SteveLRojas/1602_display_usb_controller/README.md

# 1602_display_usb_controller
Small controller board for 1602, 2004 and similar displays. It is intended to be controlled by a python script.
