SteveLRojas/1602_display_usb_controller/HW/V1.0/3D_View.png

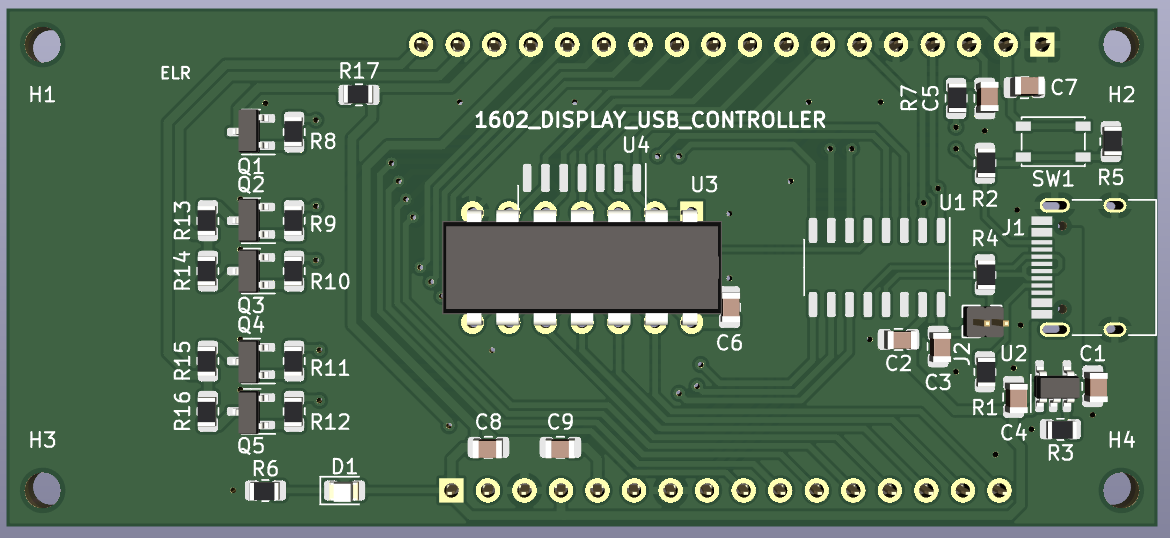
HW/V1.0/3D_View.png
