SteveLRojas/1602_display_usb_controller/HW/V1.0/BOM.ods

Part | #Needed | #Owned | Satisfied? | Location
CH552G | 1 | 10 | TRUE | Project Box
74164 | 1 | 5 | TRUE | TTL IC Box
MT9700 | 1 | 30 | TRUE | Project Box
PMBT3904 | 3 | 100 | TRUE | Project Box
LED Orange 0805 | 1 | 500 | TRUE | Project Box
USB-C Receptacle | 1 | 8 | TRUE | Connector Box
Resistor 0 ohm 0805 | 3 | 30 | TRUE | Box 8
Resistor 1k 0805 | 2 | 500 | TRUE | Box 8
Resistor 10k 0805 | 2 | 500 | TRUE | Box 8
Resistor 5.1k 0805 | 2 | 1000 | TRUE | Box 10
Resistor 4.7k 0805 | 4 | 50 | TRUE | Box 8
Capacitor 0.1u 0805 | 6 | 200 | TRUE | Project Box
Capacitor 1u 0805 | 3 | 300 | TRUE | Box 7
pin socket 1x16 2.54 | 1 | 50 | TRUE | Connector Box
pin socket 1x18 2.54 | 1 | 0 | FALSE | Connector Box
pin header 1x2 1.27 | 1 | 100 | TRUE | Connector Box
Push Button PTS810 | 1 | 10 | TRUE | Switch Box
