SteveLRojas/1602_display_usb_controller/3d_models/2004A_display_case_back.stl

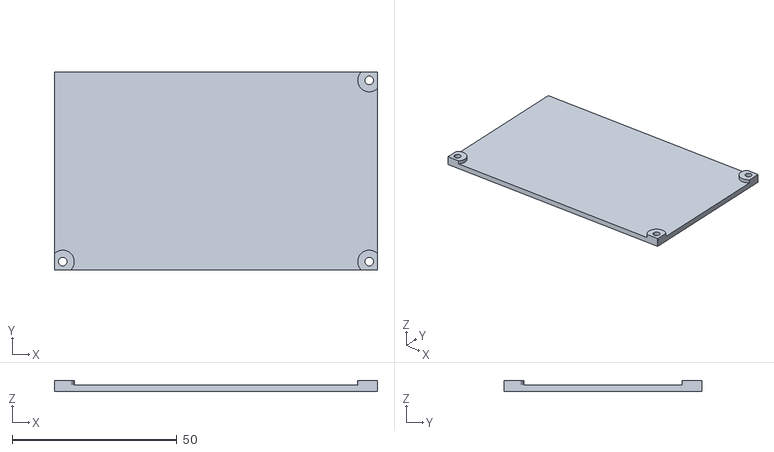
[picture p2: CAD file, 2026-07-25]
3d_models/2004A_display_case_back.stl
98.0 x 60.0 x 3.30
