SteveLRojas/1602_display_usb_controller/3d_models/2004A_display_case_front.stl

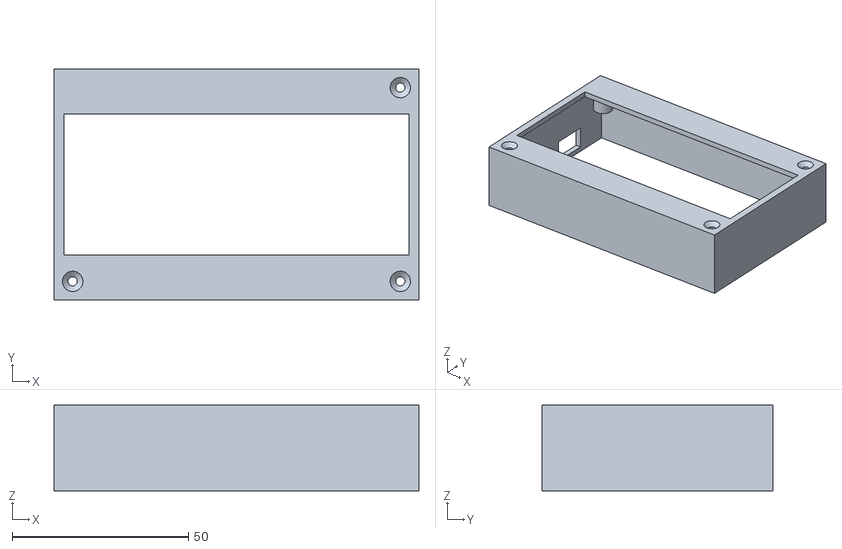
[picture p3: CAD file, 2026-07-25]
3d_models/2004A_display_case_front.stl
103.6 x 65.6 x 24.4
