SteveLRojas/1602_display_usb_controller/3d_models/RC2004C_display_case_front.stl

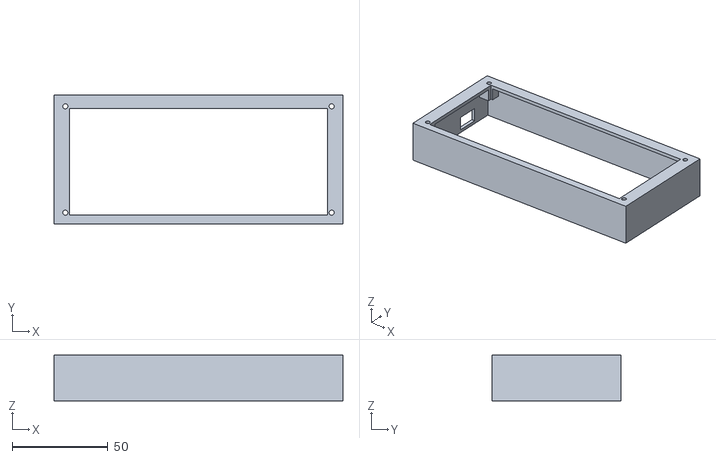
[picture p4: CAD file, 2026-07-25]
3d_models/RC2004C_display_case_front.stl
150.8 x 67.3 x 23.8
