SteveLRojas/1602_display_usb_controller/3d_models/RC2004C_display_case_back.stl

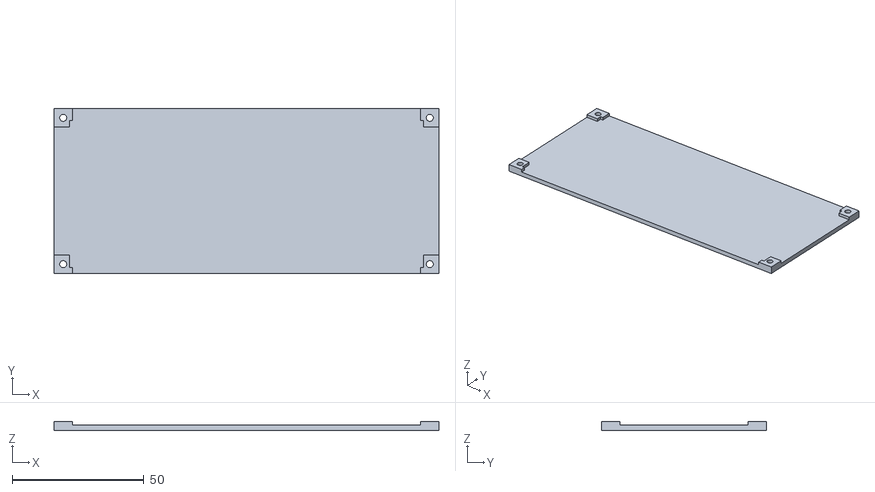
[picture p5: CAD file, 2026-07-25]
3d_models/RC2004C_display_case_back.stl
146.0 x 62.5 x 3.30
