SteveLRojas/1602_display_usb_controller/3d_models/1601_display_case_front_v8.stl

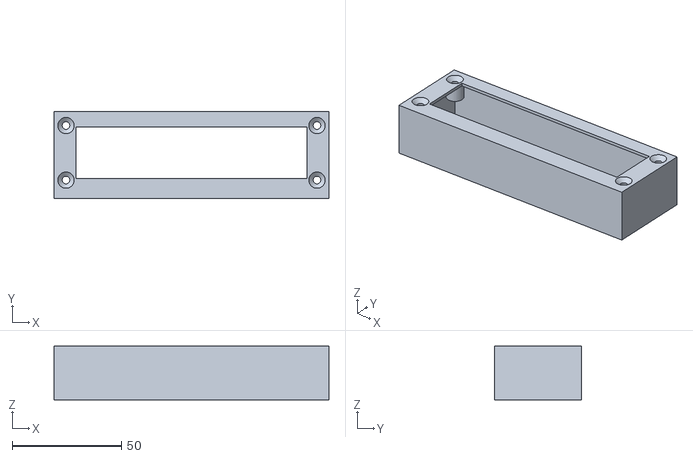
[picture p6: CAD file, 2026-07-19]
3d_models/1601_display_case_front_v8.stl
126.0 x 40.0 x 24.6
