SteveLRojas/1602_display_usb_controller/3d_models/RC1602E_display_case_front.stl

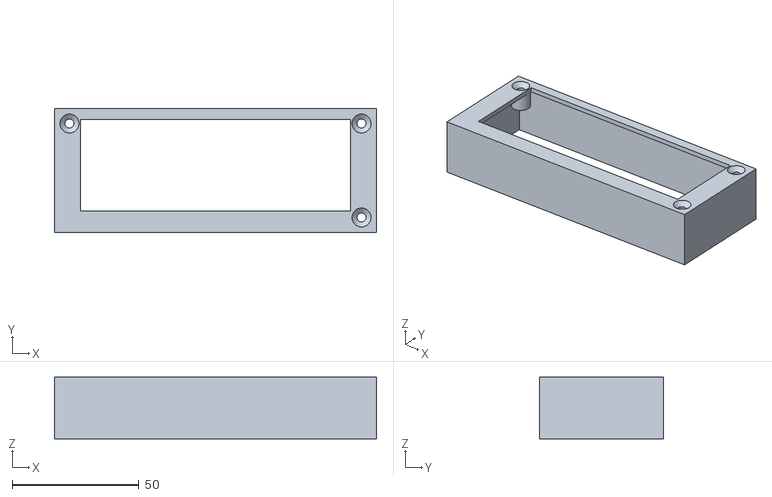
[picture p7: CAD file, 2026-07-19]
3d_models/RC1602E_display_case_front.stl
126.8 x 48.8 x 24.4
