SteveLRojas/1602_display_usb_controller/3d_models/RC1602_display_case_back.stl

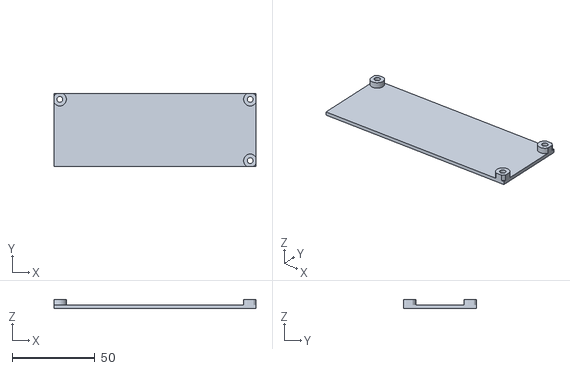
[picture p8: CAD file, 2026-07-19]
3d_models/RC1602_display_case_back.stl
122.0 x 44.0 x 5.30
