SteveLRojas/1602_display_usb_controller/3d_models/1602_display_case_back_v4.stl

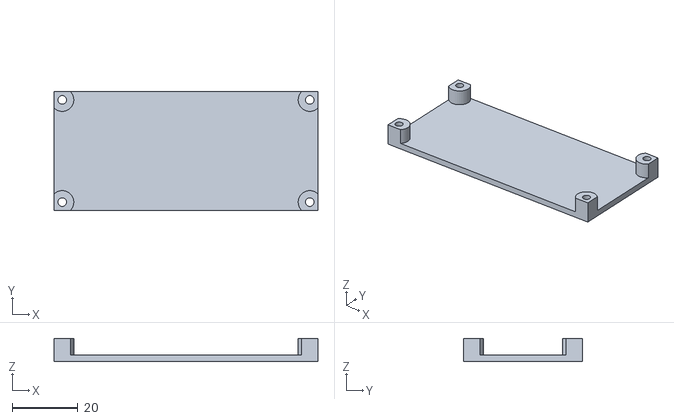
[picture p9: CAD file, 2026-07-19]
3d_models/1602_display_case_back_v4.stl
80.0 x 36.0 x 7.00
