SteveLRojas/1602_display_usb_controller/3d_models/display_spacer.stl

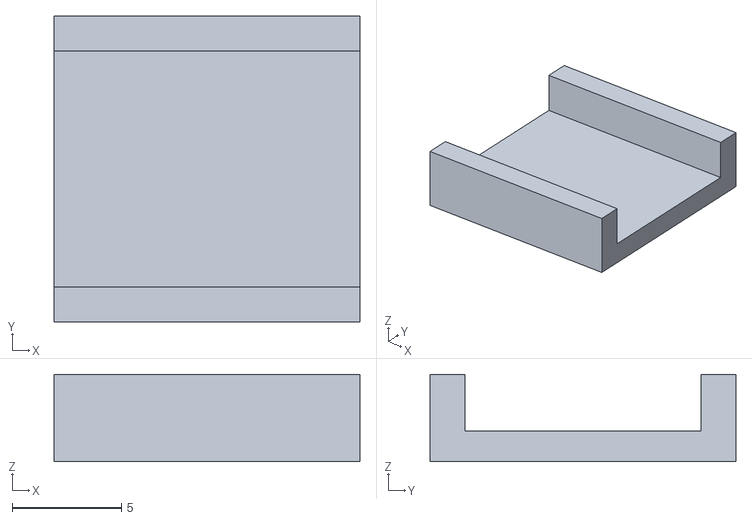
[picture p10: CAD file, 2026-07-19]
3d_models/display_spacer.stl
14.0 x 14.0 x 4.00
