SteveLRojas/1602_display_usb_controller/3d_models/1601_display_case_back_v8.stl

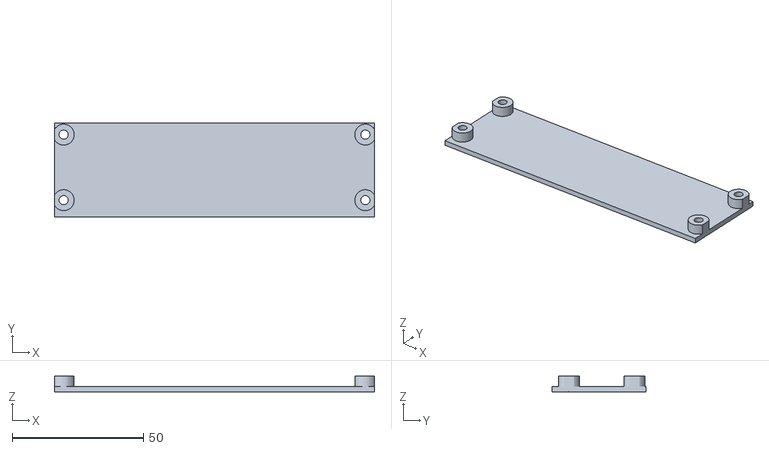
[picture p11: CAD file, 2026-07-19]
3d_models/1601_display_case_back_v8.stl
122.0 x 36.0 x 6.00
