SteveLRojas/1602_display_usb_controller/3d_models/1602_display_case_front_v4.stl

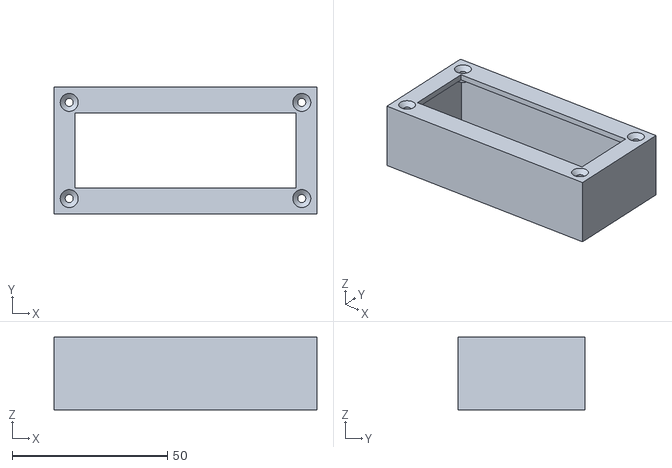
[picture p13: CAD file, 2026-07-19]
3d_models/1602_display_case_front_v4.stl
84.8 x 40.8 x 23.4
