SteveLRojas/1602_display_usb_controller/(list of files, cad)

Other CAD files:
3d_models/1602L_display_case_back_v3.stl
3d_models/1601_display_case.f3d
3d_models/1602L_display_case.f3d
3d_models/1602_display_case.f3d
3d_models/2004A_display_case.f3d
3d_models/RC1602E_display_case.f3d
3d_models/RC2004C_display_case.f3d
3d_models/display_spacer.f3d
