SteveLRojas/1602_display_usb_controller/HW/V1.0/1602_display_usb_controller.pdf

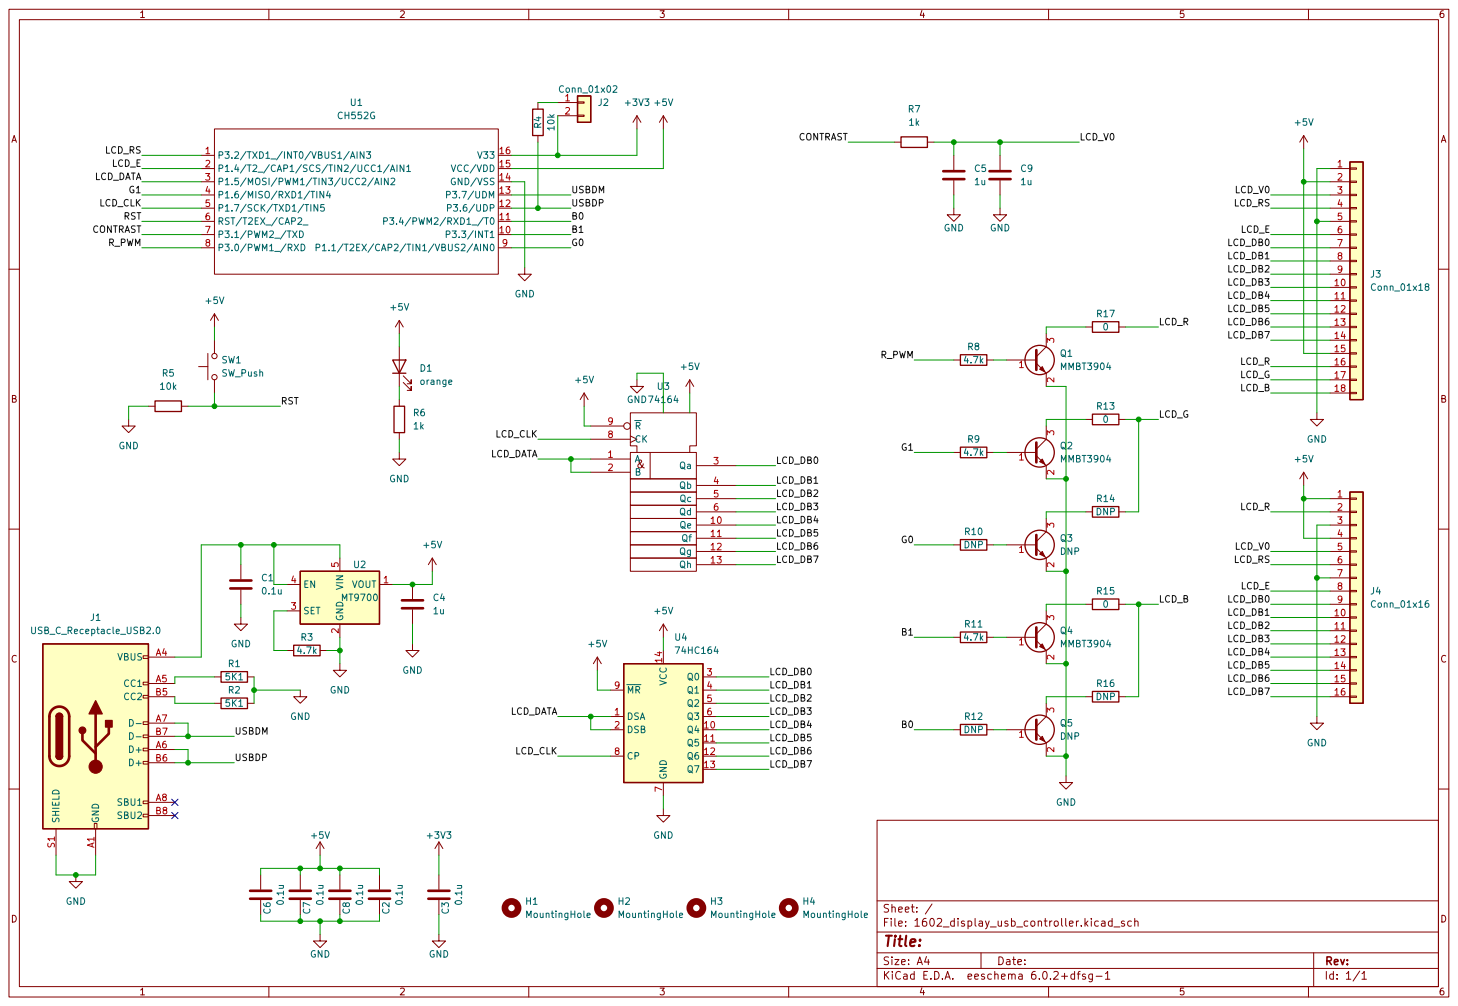
[picture p14: page 1]

2 3 Q1MMBT3904 +5V DSA 1 Q4 10 Q5 11 Q6 12 Q7 13 VCC 14 DSB 2 Q0 3 Q1 4 Q2 5 Q3 6 GND
