SteveLRojas/1602_display_usb_controller/HW/V1.0/1602_display_usb_controller.kicad_pcb

## KiCad design HW/V1.0/1602_display_usb_controller.kicad_pcb (2026-03-12)

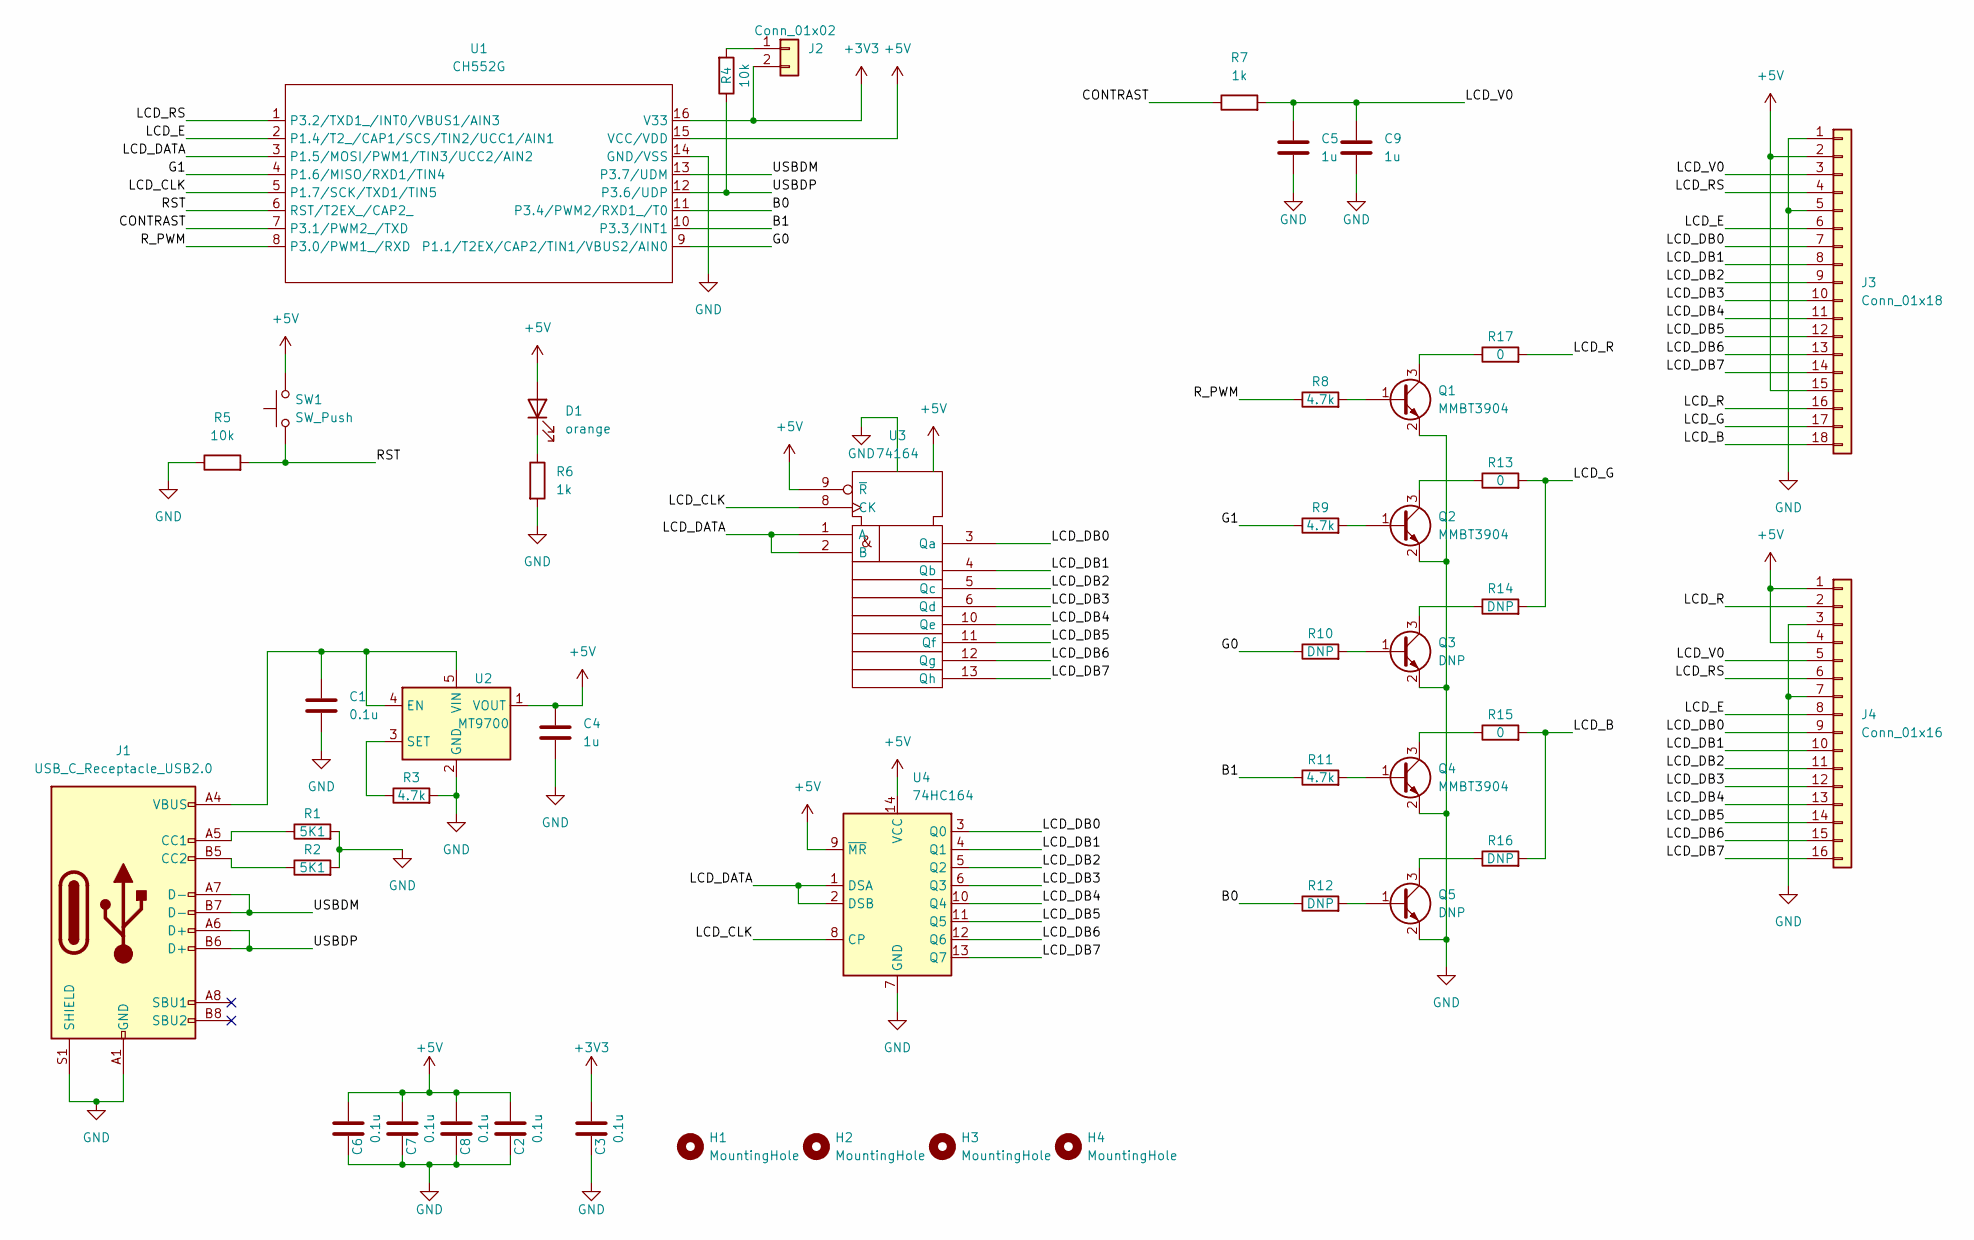
[picture p15: schematic 1602_display_usb_controller.kicad_sch]

Parts:
C1, C2, C3, C6, C7, C8: 0.1u; C_0805_2012Metric
C4, C5, C9: 1u; C_0805_2012Metric
D1: orange; LED_0805_2012Metric
H1, H2, H3, H4: MountingHole; MountingHole_2.5mm
J1: USB_C_Receptacle_USB2.0; USB_C_Receptacle_HRO_TYPE-C-31-M-12
J2: Conn_01x02; PinHeader_1x02_P1.27mm_Vertical
J3: Conn_01x18; PinSocket_1x18_P2.54mm_Vertical
J4: Conn_01x16; PinSocket_1x16_P2.54mm_Vertical
Q1, Q2, Q4: MMBT3904; SOT-23
Q3, Q5: DNP; SOT-23
R1, R2: 5K1; R_0805_2012Metric
R3, R8, R9, R11: 4.7k; R_0805_2012Metric
R4, R5: 10k; R_0805_2012Metric
R6, R7: 1k; R_0805_2012Metric
R10, R12, R14, R16: DNP; R_0805_2012Metric
R13, R15, R17: 0; R_0805_2012Metric
SW1: SW_Push; SW_SPST_PTS810
U1: CH552G; SO-16_3.9x9.9mm_P1.27mm
U2: MT9700; SOT-23-5
U3: 74164; DIP-14_W7.62mm
U4: 74HC164; SO-14_3.9x8.65mm_P1.27mm

Connections:
+3V3: C3.1, J2.2, U1.16 (V33)
+5V: C2.1, C4.1, C6.1, C7.1, C8.1, D1.2 (A), J3.2, J3.15, J4.1, J4.4, SW1.2, U1.15 (VCC/VDD), U2.1 (VOUT), U3.9 (~R), U3.14 (Vdd), U4.9 (~MR), U4.14 (VCC)
/B0: R12.1, U1.11 (P3.4/PWM2/RXD1_/T0)
/B1: R11.1, U1.10 (P3.3/INT1)
/CONTRAST: R7.1, U1.7 (P3.1/PWM2_/TXD)
/G0: R10.1, U1.9 (P1.1/T2EX/CAP2/TIN1/VBUS2/AIN0)
/G1: R9.1, U1.4 (P1.6/MISO/RXD1/TIN4)
/LCD_B: J3.18, R15.2, R16.2
/LCD_CLK: U1.5 (P1.7/SCK/TXD1/TIN5), U3.8 (CK), U4.8 (CP)
/LCD_DATA: U1.3 (P1.5/MOSI/PWM1/TIN3/UCC2/AIN2), U3.1 (A), U3.2 (B), U4.1 (DSA), U4.2 (DSB)
/LCD_DB0: J3.7, J4.9, U3.3 (Qa), U4.3 (Q0)
/LCD_DB1: J3.8, J4.10, U3.4 (Qb), U4.4 (Q1)
/LCD_DB2: J3.9, J4.11, U3.5 (Qc), U4.5 (Q2)
/LCD_DB3: J3.10, J4.12, U3.6 (Qd), U4.6 (Q3)
/LCD_DB4: J3.11, J4.13, U3.10 (Qe), U4.10 (Q4)
/LCD_DB5: J3.12, J4.14, U3.11 (Qf), U4.11 (Q5)
/LCD_DB6: J3.13, J4.15, U3.12 (Qg), U4.12 (Q6)
/LCD_DB7: J3.14, J4.16, U3.13 (Qh), U4.13 (Q7)
/LCD_E: J3.6, J4.8, U1.2 (P1.4/T2_/CAP1/SCS/TIN2/UCC1/AIN1)
/LCD_G: J3.17, R13.2, R14.2
/LCD_R: J3.16, J4.2, R17.2
/LCD_RS: J3.4, J4.6, U1.1 (P3.2/TXD1_/INT0/VBUS1/AIN3)
/LCD_V0: C5.1, C9.1, J3.3, J4.5, R7.2
/RST: R5.2, SW1.1, U1.6 (RST/T2EX_/CAP2_)
/R_PWM: R8.1, U1.8 (P3.0/PWM1_/RXD)
/USBDM: J1.A7 (D-), J1.B7 (D-), U1.13 (P3.7/UDM)
/USBDP: J1.A6 (D+), J1.B6 (D+), R4.1, U1.12 (P3.6/UDP)
GND: C1.2, C2.2, C3.2, C4.2, C5.2, C6.2, C7.2, C8.2, C9.2, J1.A1 (GND), J1.A12 (GND), J1.B1 (GND), J1.B12 (GND), J1.S1 (SHIELD), J3.1, J3.5, J4.3, J4.7, Q1.2 (E), Q2.2 (E), Q3.2 (E), Q4.2 (E), Q5.2 (E), R1.2, R2.2, R3.2, R5.1, R6.2, U1.14 (GND/VSS), U2.2 (GND), U3.7 (Vss), U4.7 (GND)
unnamed: C1.1, J1.A4 (VBUS), J1.A9 (VBUS), J1.B4 (VBUS), J1.B9 (VBUS), U2.4 (EN), U2.5 (VIN)
unnamed: D1.1 (K), R6.1
unnamed: J1.A5 (CC1), R1.1
unnamed: J1.B5 (CC2), R2.1
unnamed: J2.1, R4.2
unnamed: Q1.1 (B), R8.2
unnamed: Q1.3 (C), R17.1
unnamed: Q2.1 (B), R9.2
unnamed: Q2.3 (C), R13.1
unnamed: Q3.1 (B), R10.2
unnamed: Q3.3 (C), R14.1
unnamed: Q4.1 (B), R11.2
unnamed: Q4.3 (C), R15.1
unnamed: Q5.1 (B), R12.2
unnamed: Q5.3 (C), R16.1
unnamed: R3.1, U2.3 (SET)

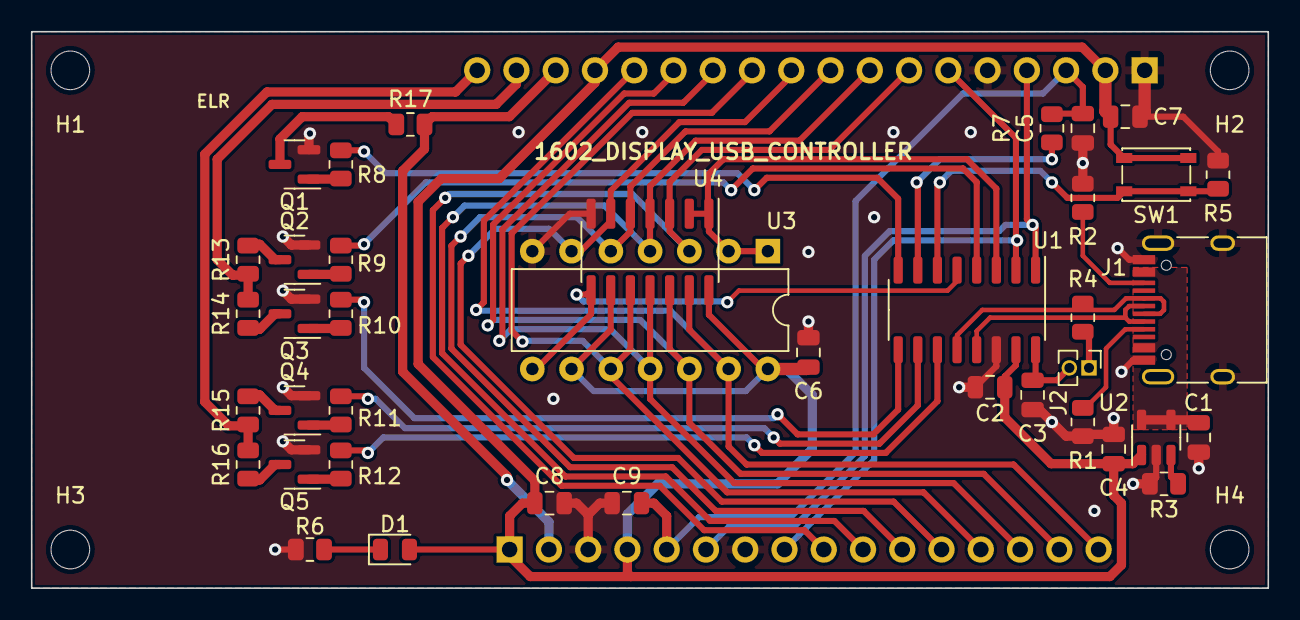
[picture p16: board 1602_display_usb_controller.kicad_pcb from above]

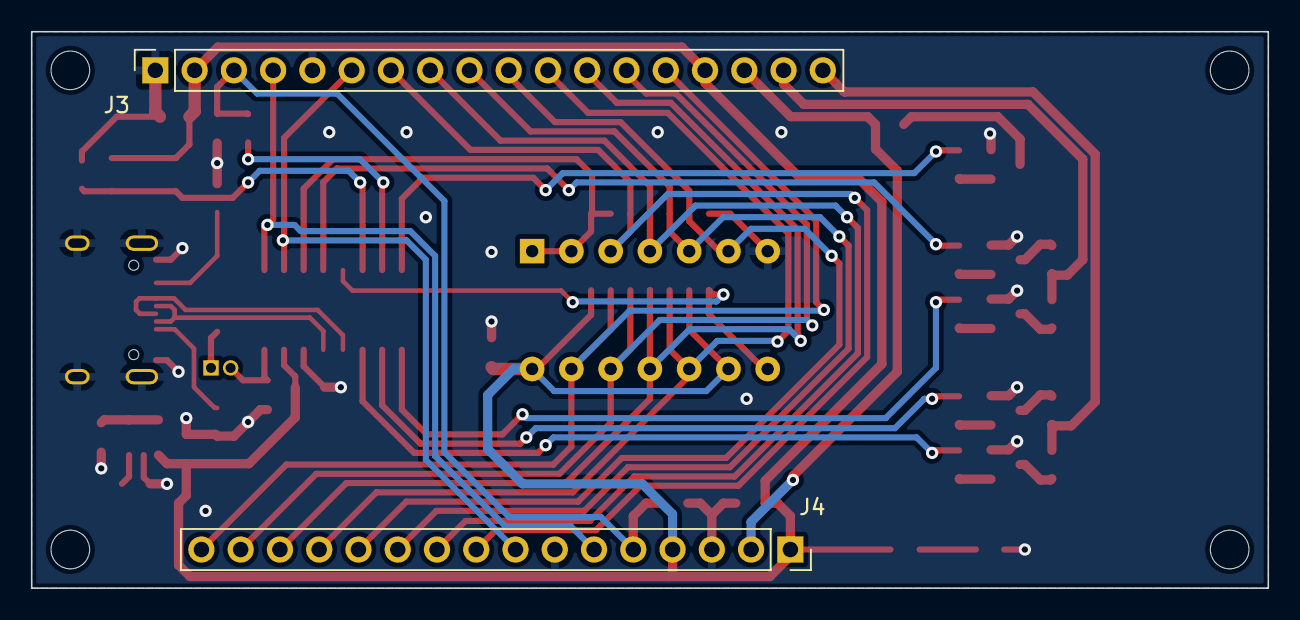
[picture p17: board 1602_display_usb_controller.kicad_pcb from below]

Board: 2 copper layers, 80.0 x 36.0 mm, 45 parts (2 on the bottom side), 44 nets.
