SteveLRojas/1602_display_usb_controller/SW/display_1602_regs.py

R_DEVICE_ID_LL = 0X00
R_DEVICE_ID_LH = 0X01
R_DEVICE_ID_HL = 0X02
R_DEVICE_ID_HH = 0X03

R_UNIQUE_ID_LL = 0X04
R_UNIQUE_ID_LH = 0X05
R_UNIQUE_ID_HL = 0X06
R_UNIQUE_ID_HH = 0X07

R_NUM_COLUMNS = 0x08
R_NUM_ROWS = 0x09
R_CURSOR_COL = 0x0A
R_CURSOR_ROW = 0x0B

R_CONTRAST = 0x0C
R_BRIGHTNESS_R = 0x0D
R_BRIGHTNESS_G = 0x0E
R_BRIGHTNESS_B = 0x0F

R_INIT = 0x10
R_CLEAR_DISPLAY = 0x11
R_CLEAR_LINE = 0x12
R_WRITE_CHAR = 0x13

R_POWER_STATE = 0x14
R_RESET_TYP = 0x15
R_COM_WDOG_LIMIT_L = 0x16
R_COM_WDOG_LIMIT_H = 0x17
