SteveLRojas/1602_display_usb_controller/(commit log)

2026-03-12 Added design files
    [1602_display_usb_controller-B_Cu.gbl, 1602_display_usb_controller-B_Mask.gbs, 1602_display_usb_controller-B_Paste.gbp, 1602_display_usb_controller-B_Silkscreen.gbo, 1602_display_usb_controller-Edge_Cuts.gm1, 1602_display_usb_controller-F_Cu.gtl, 1602_display_usb_controller-F_Mask.gts, 1602_display_usb_controller-F_Paste.gtp]
2026-03-17 Fixed CDC bug, added com watchdog, improvements in python files
    [CH552_ST7066.h, CH552_UART.h, CH552_USB_CDC.c, bouncy_text.py, display_1602_platform.py, display_1602_regs.py]
2026-07-19 Added 3D models
    [1601_display_case.f3d, 1601_display_case_back_v8.stl, 1601_display_case_front_v8.stl, 1602L_display_case.f3d, 1602L_display_case_back_v3.stl, 1602L_display_case_front_v3.stl, 1602_display_case.f3d, 1602_display_case_back_v4.stl]
2026-07-25 Added 3D models for 2004 display cases
    [2004A_display_case.f3d, 2004A_display_case_back.stl, 2004A_display_case_front.stl, RC2004C_display_case.f3d, RC2004C_display_case_back.stl, RC2004C_display_case_front.stl]
2026-11-07 Tried to make temperature display more robust
